dlynch7/MIDI2CV/README.md

# MIDI2CV
Convert MIDI messages to control voltage signals for use with a modular synthesizer

---

Jump to [Arduino Program](#arduino-program) if you want to see the current Arduino program. Otherwise, read on!

## Contents
- [Motivation](#motivation)
- [Plan](#plan)
- [Details](#details)
	- [Digital-to-Analog Converter Options](#digital-to-analog-converter-options)
		- [Filtered PWM](#filtered-pwm)
			- [1-pole LPF math](#1-pole-lpf-math)
			- [1-pole LPF for Pitch CV](#1-pole-lpf-for-pitch-cv)
			- [Sallen-Key Filter](#sallen-key-filter)
			- [2-pole Sallen-Key LPF for Pitch CV](#2-pole-sallen-key-lpf-for-pitch-cv)
		- [Dedicated DAC](#dedicated-dac)
- [Arduino Program](#arduino-program)
- [Further Plans](#further-plans)

---

## Motivation

Today, most music keyboards and synthesizers use [MIDI](https://www.midi.org/) (Musical Instrument Digital Interface), a digital communication protocol almost universally accepted in the electronic music industry. However, before MIDI's emergence in the 1980s, analog synthesizers often used _control voltage_ (CV) signals for control (surprisingly!) and communication.

I recently started building a modular synthesizer, using the [Music From Outer Space](http://musicfromouterspace.com/index.php?MAINTAB=SYNTHDIY&VPW=1910&VPH=844) (MFOS) series of modules as a starting point, and I wanted to play it with my keyboards and the DAW (digital audio workstation) on my computer.

With a device to convert MIDI messages to CV signals, I could play my modular synth using any MIDI-capable keyboard or my computer. While using a keyboard to play the modular synth makes improvising and jamming easier and more fun, I'm especially excited about the possibility of writing music on my computer and playing it back on the modular synth, because this will greatly expand my toolset for writing and recording music.

## Plan

This project is essentially a specialized digital-to-analog converter (DAC). While there are already many options for MIDI-to-CV conversion, I wanted to make my own converter.

In retrospect, this was a great decision
* I learned a lot more about MIDI and about the CV method it replaced.
* I gained an appreciation for the level of complexity required to generate some very common synth sounds (like [this one](https://youtu.be/SwYN7mTi6HM)!). I also _really_ gained an appreciation for the complexity required for polyphony in synthesizers!
* Designing and building this converter gave me an opportunity to apply what I'd learned in my coursework and improve my troubleshooting skills.

While there are [some](http://musicfromouterspace.com/index.php?MAINTAB=SYNTHDIY&VPW=1910&VPH=844) MIDI-to-CV converters out there that do the job without resorting to a microcontroller, I wanted to go the microcontroller route, for a few reasons:
* it's easier to reprogram a _&mu;_C than it is to rebuild a circuit
* more documentation available
* more room for error/experimentation
* I already had an Arduino Uno on hand

Given the last bullet point above, my converter could be represented like this:

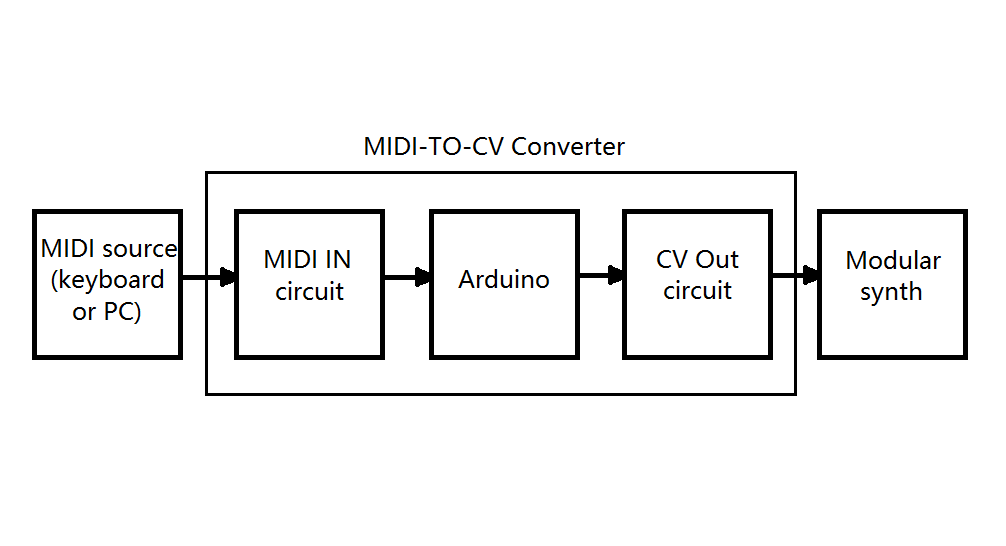
[picture p1: images/blockdiagram.png]
Block Diagram


-------

## Details

Sort of. Rather than try to explain the MIDI communication protocal myself, here are some other websites and people who've done a great job explaining it:

* This [Instructable](http://www.instructables.com/id/What-is-MIDI/) gives a comprehensive and comprehensible overview of MIDI. The author also wrote an [Instructable](http://www.instructables.com/id/Send-and-Receive-MIDI-with-Arduino/) about using an Arduino to send and receive MIDI messages; this particular Instructable was an invaluable resource throughout my project.
* This [blog post](http://www.notesandvolts.com/2015/02/midi-and-arduino-build-midi-input.html) also gives a clear description of the MIDI input circuit.
* Here is a [library](https://github.com/FortySevenEffects/arduino_midi_library) of code for Arduino to interface with MIDI. This is what I used to interface with my MIDI keyboard.

The schematic below shows the three circuits required by MIDI. Since my project only has a MIDI input, I only used the topmost circuit.

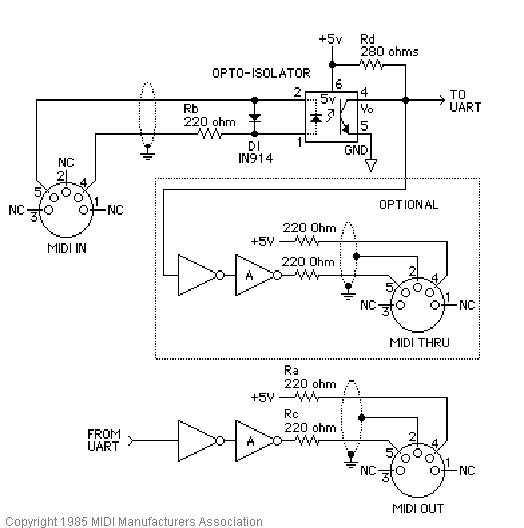
[picture p2: images/midicircuit.gif]
MIDI circuit


**Note:** MIDI transmits at a baud rate of 31250. The Arduino IDE doesn't support this baud rate, so if you want to print data for debugging purposes, you'll have to use an additional program to view serial data. I use [PuTTY](http://www.chiark.greenend.org.uk/~sgtatham/putty/download.html). Just follow [this tutorial](http://acidotunismo.com/en/2013/10/arduino-uno-midi-in-debugging-with-putty-windows/).

Briefly, MIDI uses bytes to convey a wide array of musical information, such as
* **note On/Off** (are you pressing a key?)
* **pitch** (what key are you pressing?)
* **velocity** (how hard are you pressing the key?)
* **pitchbend** (most MIDI keyboards have a control wheel for bending a note up or down)
* **modulation** (most MIDI keyboards also have a modulation wheel that can be assigned to modulate another parameter, such as vibrato, filter cutoff frequency, etc.)
* **sustain** (are you pressing down on a sustain pedal, like on a piano?)

There are many, many more MIDI messages available, but these are some of the most common and are also the ones I use most often when playing.

CV conveys the same information as MIDI but does it differently, using both analog and logic-level signals.
* MIDI **note on/off** messages map to logic-level **GATE** and **TRIGGER** CV signals.
* Pretty much every other MIDI message maps to an analog CV signal
    * pitch
    * velocity
    * modulation
The beauty of CV is that these analog CV signals are interchangeable. This flexibility opens more possibilities for sound design. Here are just a few examples:
* velocity CV -> filter cutoff frequency (sound brightens with harder keypresses)
* pitch CV -> oscillator mix (use pitch to blend between two different waveforms)
* modulation -> low frequency oscillator (LFO) amplitude (LFOs are another signal generator that will also output CV signals and can modulate more aspects of your sound)

### Digital-to-Analog Converter Options

I considered two methods for converting the Arduino's digital output to analog CV signals, and I actually wound up using both methods.

1. Dedicated DAC chip
2. Pulse Width Modulation (PWM) + Low-Pass Filter (LPF).

Before this project, I never used a dedicated DAC, and because I initially felt hesitant about that method, I decided to see if I could do all my digital-to-analog conversion using filtered PWM.

#### Filtered PWM

The Arduino's [analogWrite()](https://www.arduino.cc/en/Reference/AnalogWrite) function uses PWM to approximate a voltage between 0V and 5V. While some devices (LEDs, DC motors) can be controlled directly by PWM, the synthesizer is not one of those devices (unless you want to generate some interesting 'talking-robot' sounds). For PWM to interface nicely with my modular, it had to be low-pass filtered to 'smooth out' the signal. The simplest LPF is a resistor-capacitor (RC) circuit, as shown below, so I started there, with the expectation that a more sophisticated filter might be necessary.

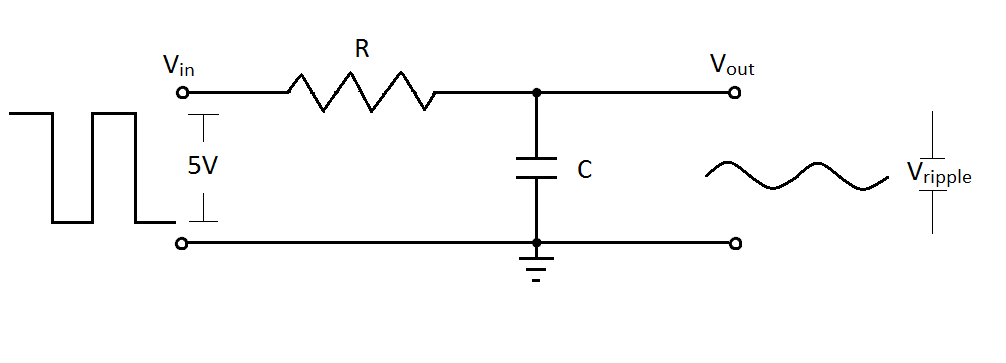
[picture p3: images/lpf_1pole_circuit.png]
RC circuit


A buffer is necessary to prevent whatever is connected to the filter's output from loading down the filter. This can be done with a voltage-follower, shown below with the original RC circuit.

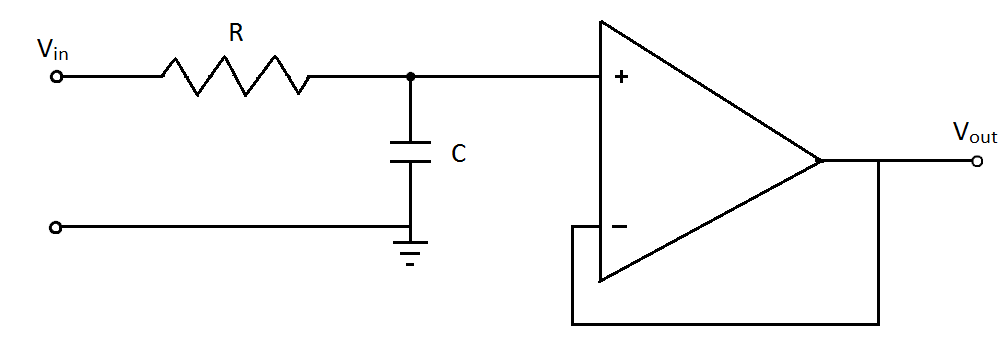
[picture p4: images/lpf_1pole_buffer.png]
Buffered RC circuit


Note: I might use "bandwidth frequency" and "cutoff frequency" interchangeably, because for low-pass filters, they mean the same thing.

An RC circuit is a 1-pole filter, which means that above its cutoff frequency, the filter has a slope of -20 dB per decade (i.e. if the filter attenuates a 100 Hz input signal by 20 dB, it will attenuate a 1000 Hz input signal by 40 dB). The Bode plot below illustrates the frequency response of this circuit.

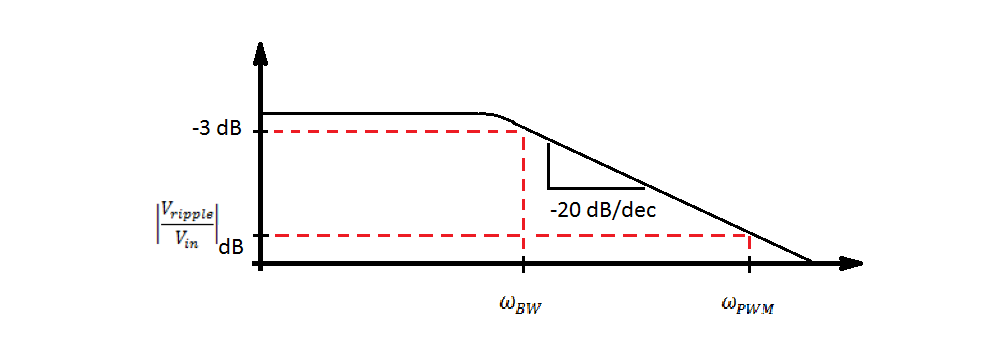
[picture p5: images/lpf_1pole.png]
RC bode


This Bode plot is also quite helpful for understanding my design process; the process applies for higher-order filters, too, and the only difference is that the Bode plot would look different (it would have a steeper slope).

For clarity, I want to list the parameters relevant to using an RC circuit to filter a PWM signal from the Arduino.
* Arduino PWM frequency
* LPF cutoff frequency
* PWM amplitude
* Ripple amplitude (amplitude of filtered PWM signal)

For the RC circuit described above, the cutoff frequency is a function of the resistor and capacitor values, R and C. Also, the frequency and amplitude of the Arduino's PWM signal are fixed: 490 Hz (980 Hz on pins 5 and 6) and 5V, respectively.

The design procedure then is this:
```
1. Determine a desirable ripple magnitude.
2. Given the filter's -20 dB/dec slope, calculate the cutoff frequency required to achieve the ripple amplitude.
```

##### 1-pole LPF math
  The transfer function for an RC LPF is

  lpf_1pole_TF		[1]

  The bandwidth frequency or cutoff frequency of a filter is the frequency at which the filter's output is 3 dB less than its DC level. For an RC LPF, this is simply -3 dB.

  lpf_1pole_BW_TF		[2]

  Solving for &omega; gives the cutoff frequency as a function of R and C:

  lpf_1pole_BW_freq		[3]

  Define RC as a time constant _&tau;_, and the equation above can be rewritten as

  lpf_1pole_BW_tau		[4]

Below, I'll describe how I followed this procedure to design a filter to smooth out a CV signal which could be used for pitch control:

##### 1-pole LPF for Pitch CV
  **Spoiler Alert!** This design doesn't work (as I'll explain below). That's why there are two section below labeled [Sallen-Key Filter](#sallen-key-filter) and [2-pole Sallen-Key LPF for Pitch CV](#2-pole-sallen-key-lpf-for-pitch-cv). Nevertheless, it's important to understand why this filter didn't work and why a more sophisticated filter was required.

  Recall that step 1 of the design procedure required me to determine a desirable ripple amplitude. Since I was designing a filter to generate a pitch CV signal, this ripple amplitude corresponded to a variability in pitch, kind of like a vibrato, so I had to decide how much vibrato I was willing to tolerate (not much).

  * I measured pitch variation in _cents_. A cent is 1/100th of a semitone (the difference in pitch between two adjacent keys on a piano, like C and C#).
  * I decided to tolerate +/- 5 cents variation in pitch, or a magnitude of 10 cents.
  * The voltage-controlled oscillator (VCO) of my synth is calibrated to 1V/octave, so two pitch CV signals 1V apart will make the VCO generate sounds 1 octave apart.
  * There are 12 semitones in an octave, so 1V/octave is equivalent to 1/12V per semitone.
  * Thus, 1 cent equals 0.8333 mV, and 10 cents equals 8.333 mV.
  * pitch_var_magnitude
  * Recall that for most pins on the Arduino, the PWM frequency is 490 Hz or 3079 rad/s, and the PWM signal switches between 0V and 5V.
  * Solving the equation above for time constant &tau; gives &tau; = 0.196 s.
  * Plugging this _&tau;_ into equation 3 above gives a cutoff frequency of 5.11 rad/s or 0.813 Hz. That's pretty low!
  * Using the MATLAB script [lpf1p.m](/matlab/lpf1p.m), I examined the frequency response and 0-5V step response of this filter, for a PWM frequency of 490 Hz, both of which are plotted below. Using the MATLAB function [stepinfo()](https://www.mathworks.com/help/control/ref/stepinfo.html), I found the settling time of this filter to be about 0.76 seconds. Considering the input PWM frequency is 490 Hz, that's an unacceptably slow settling time. Even if I used pins 5 or 6 (980 Hz PWM instead of 490 Hz), the settling time would have been around 0.38 s, still way too slow.

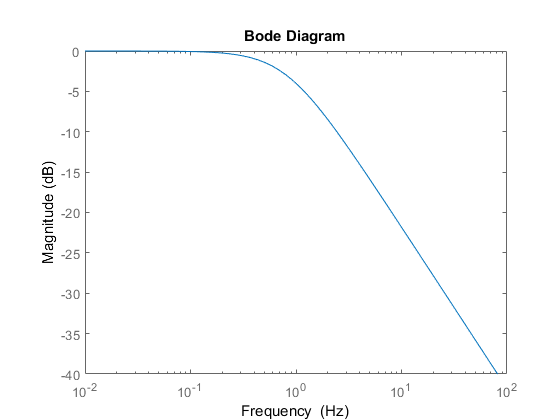
[picture p6: images/matlab_plots/lpf_1pole_bode.png]
1-Pole LPF Bode
  
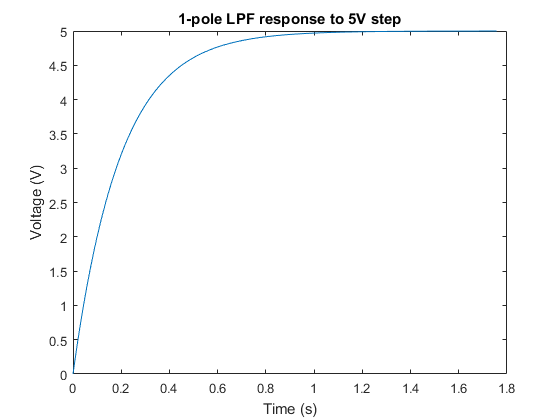
[picture p7: images/matlab_plots/lpf_1pole_5V_step_response.png]
1-Pole LPF 0-5V Step
  

  If I was determined to use a 1-pole RC LPF, I would have to tolerate more pitch variability. Instead, I decided to try a 2-pole filter, which would have a -40 db/dec slope instead of the RC LPF's -20 db/dec slope.

##### Sallen-Key Filter
A [Sallen-Key filter](https://en.wikipedia.org/wiki/Sallen%E2%80%93Key_topology) is an active 2-pole filter that can be designed to work as a cascade of two 1-pole RC filters.

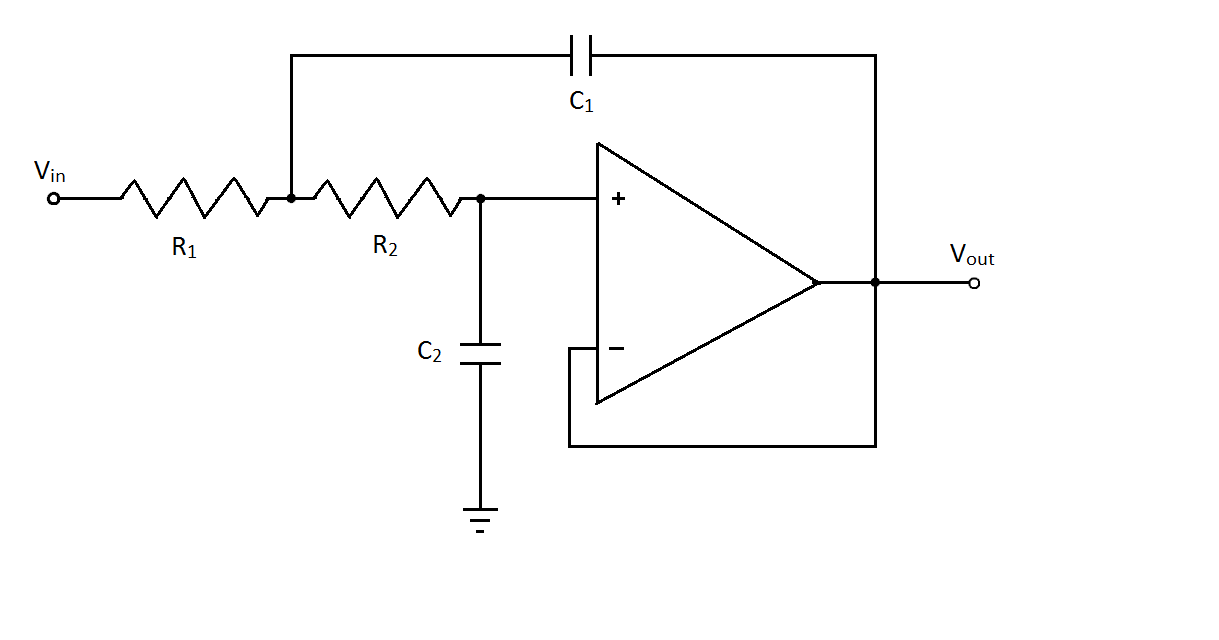
[picture p8: images/sallen-key_lpf.png]
Sallen-Key LPF


The generic transfer function for a Sallen-Key filter is

sallen-key_TF_generic		[5]

To make a Sallen-Key LPF,

sallen-key_LPF_Zs		[6]

The generic transfer function above becomes

sallen-key_LPF_TF		[7]

where

sallen-key_LPF_comp2canon		[8]

Here, _&omega;<sub>o</sub>_ is the natural frequency of the filter and _&zeta;_ is the damping coefficient of the filter.

For second-order systems, such as this filter, there is a quality factor _Q_ defined as

quality_factor		[9]

For a maximally sharp corner, Q = 1/2. This makes the Sallen-Key LPF behave as two cascaded 1-pole LPFs.
To reduce the number of unknown variables, let _C<sub>1</sub>_ = _C<sub>2</sub>_ = _C_, _R<sub>1</sub>_ = _R_, and _R<sub>2</sub>_ = _m*R_. Then, equation 9 becomes

quality_factor_compvals		[10]

Solving for _m_ gives _m_ = 1, which means _R<sub>1</sub>_ = _R<sub>2</sub>_. With _C<sub>1</sub>_ = _C<sub>2</sub>_ = _C_ and _R<sub>1</sub>_ = _R<sub>2</sub>_ = _R_, the filter's natural frequency becomes

SK_natF_compvals		[11]

and the damping coefficient _&zeta;_ becomes 1 (i.e. the filter is critically damped). Above the natural frequency, the filter has a slope of -40 dB/dec (twice as steep as a 1-pole LPF).

##### 2-pole Sallen-Key LPF for Pitch CV

Designing a Sallen-Key LPF to smooth PWM requires finding a natural frequency _&omega;<sub>o</sub>_ that yields the desired ripple amplitude. Starting with the canonical form of the filter transfer function,

SK_TF_canonical		[12]

and evaluating the transfer function along the imaginary axis _s_ = _j%omega;_, the transfer function becomes

SK_TF_canonical_jw		[13]

Recall that this filter is critically damped (_&zeta;_ = 1), so the equation above simplifies to

SK_TF_canonical_jw_simp		[14]

The magnitude of the filter is

SK_TF_mag		[15]

and the magnitude of the filtered PWM signal, normalized by the 5V PWM amplitude, is

SK_TF_ripplemag		[16]

Solving the equation above for _&omega;<sub>o</sub>_ gives the filter's natural frequency as a function of the PWM frequency _&omega;<sub>PWM</sub>_ and desired ripple amplitude |G<sub>ripple</sub>|:

SK_natF_from_PWM		[17]

Recall from the design procedure for the 1-pole LPF that the desired normalized ripple magnitude is 0.001666. I decided to use the faster PWM available from pins 5 and 6 on the Arduino, so _&omega;<sub>PWM</sub>_ = 6158 rad/s. Plugging these values into the equation above gives

SK_natF_solved

The last step of the design procedure is to choose values of _R_ and _C_ to achieve this natural frequency. With the components I had readily available, I chose _R_ = 39 k&Omega; and _C_ = 0.1 &mu;F, resulting in a natural frequency of 256 rad/s or 40.8 Hz.

How well does this filter perform? I wrote a short MATLAB script ([lpf2p_calc.m](/matlab/lpf2p_calc.m)) to generate a Bode plot and a 0-5V step response as well as some characteristics of the step response. Both plots are below. The normalized magnitude of the filtered PWM signal is 0.0017 and the step response settling time is roughly 0.02 seconds.

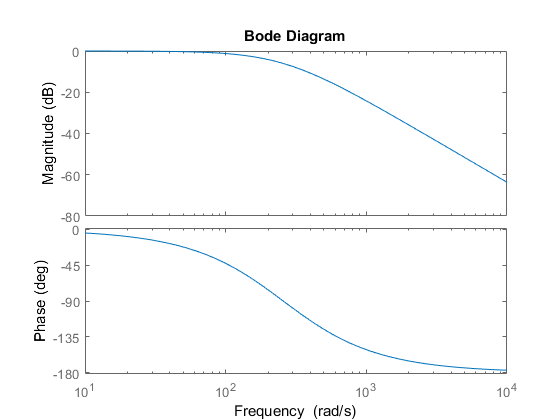
[picture p9: images/matlab_plots/lpf_2pole_bode_actual.png]
lpf_2pole_bode_actual


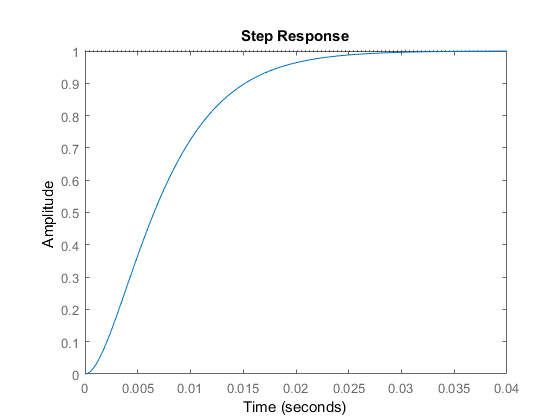
[picture p10: images/matlab_plots/lpf_2pole_5V_step_response_actual.png]
lpf_2pole_5V_step_response_actual


#### Dedicated DAC
Although the Sallen-Key LPF did its job well, the whole filtered PWM solution still didn't work for generating _pitch CV_ (it works fine for velocity modulation CVs), because of limited PWM resolution: the Arduino function [analogWrite()](https://www.arduino.cc/en/Reference/AnalogWrite) only has 8-bit resolution. This means the Arduino can use PWM to approximate 256 different values between 0V and 5V.

MIDI notes span 10+ octaves, or 128 notes, so you'd think 256 different PWM duty cycles would be enough to generate pitch CV, but you'd be wrong! Look at this table to see why:

| DAC Resolution | Number of Steps | Steps/semitone  | Acceptable? |
| --- |:---:| ---:| ---:|
| 8-bit | 256 | 2.1333 | No! |
| 12-bit | 4096 | 34.1333 | Yes. |
| 16-bit | 65536 | 546.1333 | Yes! |

With a non-integer number of steps per semitone, it's hard to get an in-tune pitch out of the synthesizer. Ascending up the keyboard from C0, the lowest MIDI note, an 8-bit DAC (comparable to analogWrite() on the Arduino) will get out of tune much sooner than a 12-bit or 16-bit DAC.

I anticipated having to manually tune my DAC values, so I opted for a 12-bit DAC, the [MCP4725](https://www.sparkfun.com/products/12918) (as opposed to a 16-bit DAC; manually tuning DAC values for that would be a nightmare!). This DAC comes on a breakout board and there's an [Arduino library](https://github.com/adafruit/Adafruit_MCP4725) for it, so using it in my project was pretty straightforward. [This tutorial](https://learn.sparkfun.com/tutorials/mcp4725-digital-to-analog-converter-hookup-guide) is also pretty helpful for getting started.

The tutorial comes with a simple sine wave generator. I uploaded that code to the Arduino and made a quick (and very shaky) video of the results. **Keep the volume low!**

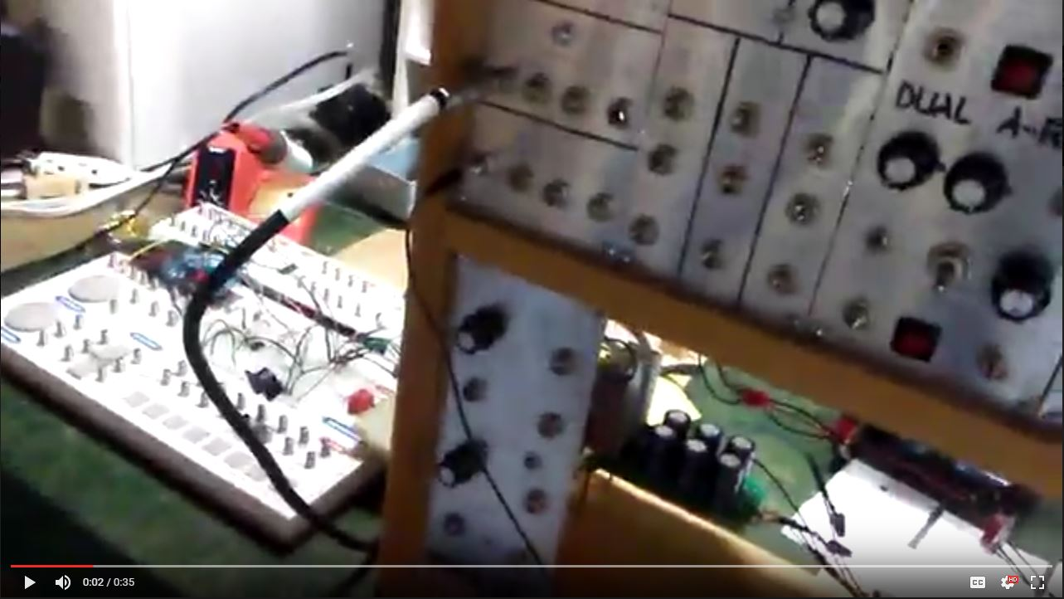
[picture p11: images/video_links/sine_wave.JPG]
sine_wave (https://drive.google.com/file/d/0B5OA5X2encENVUV6MTRTQzJISjA/view?usp=sharing)


and here's a second one:

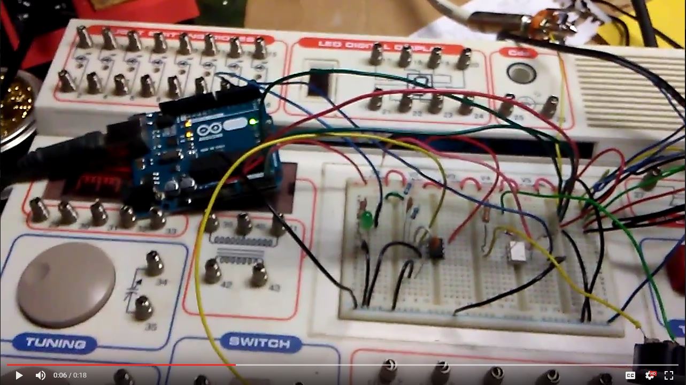
[picture p12: images/video_links/sine_wave2.JPG]
sine_wave2 (https://drive.google.com/file/d/0B5OA5X2encENRVZDSG9PbEpKSXM/view?usp=sharing)


Although I initially planned to design my MIDI-to-CV converter to generate pitch CV signals over a 10-octave range, at this point I decided to switch to a 5-octave range for 2 reasons:

1. My synth's VCO has a pretty good operational range, more than 8 octaves, but my MIDI keyboards only have 3-, 4-, and 5-octave ranges. I can expand that range by using the Coarse and Fine tuning knobs on the VCO.
2. Since the Arduino's PWM has a range of 5V, generating CV signals of >5V requires amplification and connection to my synth's power supply (a +/- 12 V bipolar power supply) Although I wound up amplifying the PWM signal for velocity CV, I didn't want to connect too many things to the synth's power supply because I want to be able to power more modules in the future (more VCOs, more envelope generators, etc).

With a 5-octave (5V) range in mind, I could calculate the values I'd need to write to the DAC:

1. Since the DAC has 12-bit resolution, it can output 4096 different voltages between 0V and V<sub>cc</sub> (5V). So, one volt corresponds to 4096/5 = 819.2.
2. An octave comprises 12 semitones, and with my 1V/octave VCO, a semitone corresponds to 1/12 V. So, one semitone corresponds to (4096/5)/12 = 68.2666. This means that to get C0 from the VCO, I'd write 0 to the DAC; to get C#0, I'd write 68; to get D0, I'd write 136, etc.

I used [this Excel spreadsheet](/math/MIDI_note_number_to_DAC_input.xlsx) to find the values I'd need to write to the DAC, assuming ideal conditions (Vcc = 5.00000V, perfectly in-tune VCO, etc).

Because tuning my VCO wasn't going well, I decided to adjust the numbers generated from the Excel spreadsheet so I'd have an in-tune playable synth. Later, I plan to properly tune the VCO and revert to the predicted DAC values generated by the Excel spreadsheet.

Once I adjusted the numbers I was writing to the DAC, I made another video:

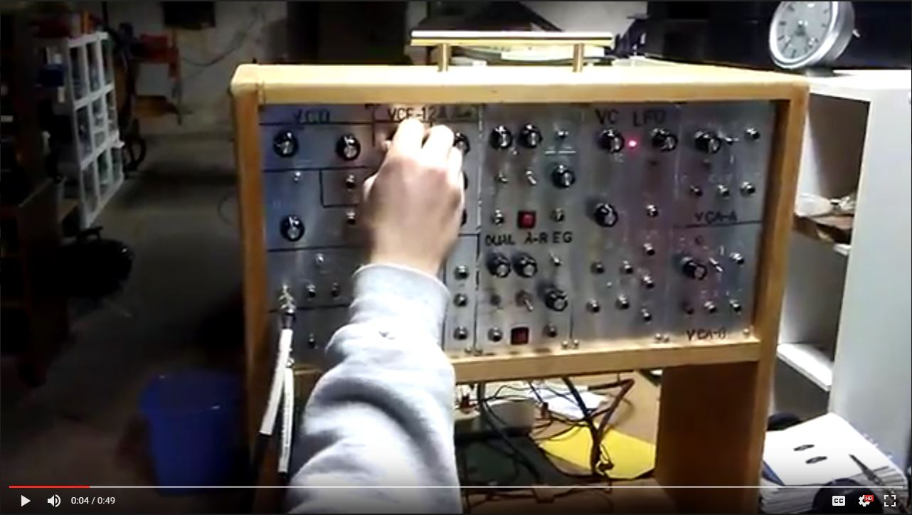
[picture p13: images/video_links/pitch_cv_only.JPG]
pitch_cv_only (https://drive.google.com/file/d/0B5OA5X2encENdHJBQ3NPME1DWUE/view?usp=sharing)


In that video, I'm manually adjusting the cutoff frequency of my synth's voltage-controlled filter (VCF) and playing my keyboard with my left hand (out of frame, sorry). Here's another video:

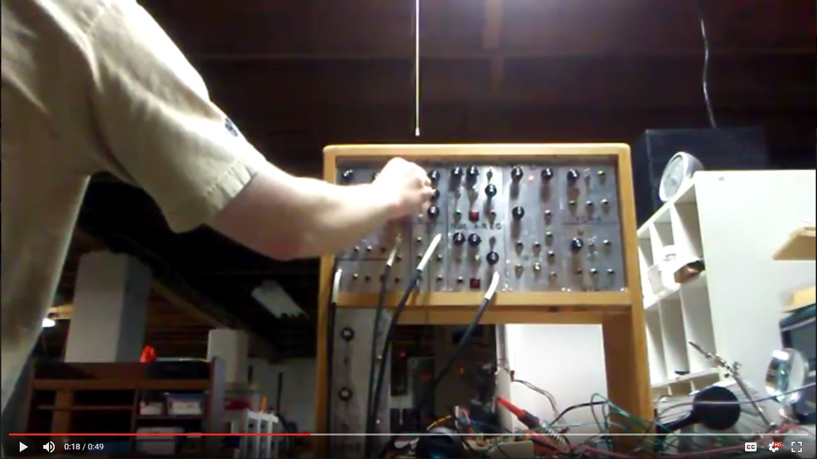
[picture p14: images/video_links/pitch_cv_w_EG.JPG]
pitch_cv_w_EG (https://drive.google.com/file/d/0B5OA5X2encENVm5hWGRBNEFaVHc/view?usp=sharing)


In that video, I rigged up a simple patch on the synth: I connected the output of my envelope generator (EG) to the cutoff CV input on the VCF. I used a similar method in the next 2 videos, when I began developing the velocity CV

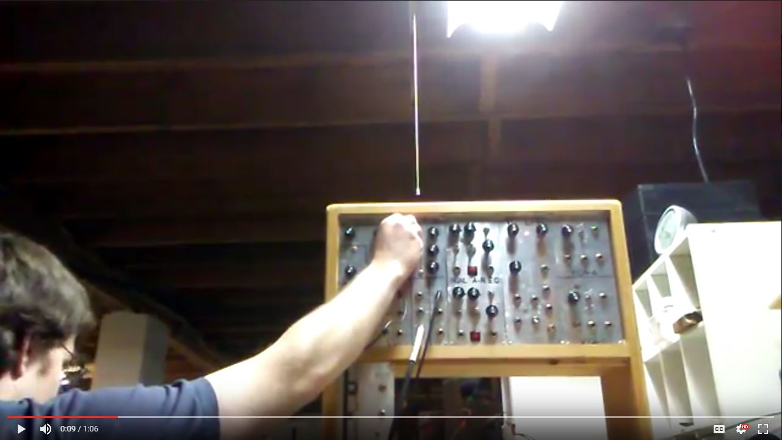
[picture p15: images/video_links/pitch_and_vel_cv.JPG]
pitch_and_vel_cv (https://drive.google.com/file/d/0B5OA5X2encENYnlNdWZTQ3JnVFU/view?usp=sharing)


In that video, the Arduino is just generating logic-level velocity CV signals, so I'm manually adjusting the VCF's cutoff frequency to add some more musicallity. In the next video, I got the velocity CV fully working so I wouldn't have to tweak any knobs while playing.

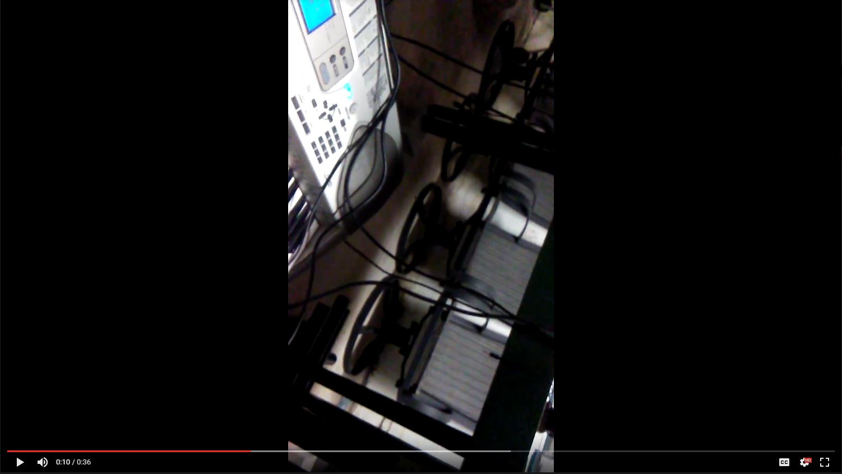
[picture p16: images/video_links/pitch_and_vel_cv2.JPG]
pitch_and_vel_cv2 (https://drive.google.com/file/d/0B5OA5X2encENS1duMlhIT1NpUWc/view?usp=sharing)


My apologies for the shakiness of the last video, and my apologies to Herbie Hancock for my rendition of "Chameleon"!

Here are some **important things** I learned while implementing velocity control:
* Although the Arduino can put out 0V, the TL-082 op-amp I used for my Sallen-Key LPF can't actually reach its rail voltages. As a result, when I connected the op-amp's V+ rail to the Arduino's 5V pin and the op-amp's V- rail to ground, the op-amp couldn't put out a signal as low as 0V!
* The solution to this problem is to connect the op-amp's V- to a negative voltage instead of ground. The only negative supply I had was -12V from the synth power supply. By using -12V and +12V instead of 0V and +5V, I could also amplify the velocity CV to cover a wider range! I'm still troubleshooting a non-inverting op-amp circuit I designed for this purpose, and I'll update this page once I get it working.

## Arduino Program
Here is my [Arduino program](/arduino/midi2pitchvelcv.ino), in its current state. I plan to update it according to my plans below:

## Further Plans
Above, I mentioned that I want to expand the range of my velocity CV and I have some troubleshooting to do on that front. I have some other features I want to implement:
* **Pitchbend:** implementing pitchbend should be straightforward.
  * I have to decide on a _pitchbend range_ (+/-2 semitones is common, although some cool sounds can be made with wider ranges like +/- 12 semitones). I would actually like to make that a parameter I could provide to the Arduino through some kind of interface, such as hex LEDs and either up/down buttons or a scrollwheel.
  * Once I have chosen a pitchbend range, I have to convert the MIDI pitchbend message to an increment/decrement and add that value to the value I'm writing to the DAC to generate the pitch CV. MIDI splits the pitchbend message into two parts, one for coarse resolution and one for fine resolution; I want to see how things sound if I just use coarse resolution before I attempt to use coarse + fine.
* **Modulation CV:** this is almost identical to velocity CV, so it should be easy to implement.
* **Gate and Trigger CV:** I have the Gate CV almost working, I just have to find what voltage the synth expects for a Gate HIGH condition and amplify the signal to reach that voltage. Getting the Trigger CV working will be a little trickier, because it's a momentary signal, but I suspect I can implement that entirely in the Arduino code, using a simple state machine.
* **Sustain CV:** I've found that I use the sustain pedal a lot when I play, so I'd really like to get this working. I have to understand how the MIDI sustain message works first. If it doesn't alter the MIDI Note On/Off message, I can combine the sustain and note on/off messages to generate the Gate CV.
* **PCB and Front Panel:** Since this whole project is for my modular synth, I'd like to build it as a module that I can add to the synth itself.

--------
