dlynch7/MIDI2CV/math/filter_derivations.docx

Low-pass filter as a rudimentary DAC

1- 1-pole LPF: RC circuit

Start with schematic including input and outputs (PWM and smoothed PWM). Also explain unity-gain buffer and include schematic of RC + buffer.

Transfer function:

(V_(out))/(V_(in))=1/(sRC+1)

Bandwidth:

-3 dB=1/(√2)=|(V_(out))/(V_(in))|=|1/(sRC+1)|=|1/(jω_(BW) RC+1)|=1/(√(1+(ω_(BW) RC)^2))

Solving for omega gives the bandwidth frequency as a function of R and C:

ω_(BW) =1/(RC) or f_(BW) =1/(2πRC)

Define

τ=RC

Equivalently,

τ=1/(ω_(BW))=1/(2πf_(BW))

For a given musical pitch, +/- 5 cents is an acceptable variation in pitch. The VCO is calibrated to 1V/octave or, equivalently, 1/12 V per semitone. A cent is 1/100th of a semitone, or 0.83333333 mV. A range of +/- 5 cents (10 cents) corresponds to 8.3333 mV

|(V_(out))/(V_(in))|_(ω_(PWM)) =(8.333 mV)/(5 V)=0.001666=1/(√(1+(ω_(PWM) τ)^2))

The Arduino Uno’s PWM-enabled pins output at 490 Hz or approximately 3079 rad/s, except pins 5 and 6, which output at 980 Hz or approximately 6158 rad/s. Taking ω_(PWM) =3079 (rad)/s , solve for τ :

τ=0.196 s

With a time constant τ = 0.196 s, the cutoff frequency of this filter is ω_(BW) =5.11 rad/s or f_(BW) =0.813 Hz .

2- 2-pole LPF: Sallen-Key filter

Sallen-Key TF:

(V_(out))/(V_(in))=(Z_3 Z_4)/(Z_1 Z_2 +Z_3 (Z_1 Z_2 )+Z_3 Z_4)

For an LPF,

Z_1 =R_1 , Z_2 =R_2 , Z_3 =1/(sC_1), and Z_4 =1/(sC_2)

The TF above becomes

(V_(out))/(V_(in))=1/(s^2 R_1 R_2 C_1 C_2 +sC_2 (R_1 +R_2 )+1)=(ω_o^2)/(s^2 +2αs+ω_o^2)

where

ω_o =1/(√(R_1 R_2 C_1 C_2)) , 2α=(R_1 +R_2)/(C_1 R_1 R_2)=2ζω_o , and ζ=((R_1 +R_2 )√(R_1 R_2 C_1 C_2))/(2C_1 R_1 R_2) .

Define a “quality factor” Q:

Q=(ω_o)/(2α)=(√(R_1 R_2 C_1 C_2))/(C_2 (R_1 +R_2 ))

For a maximally sharp corner, Q = ½.

To reduce the number of unknown from four ( R_1 , R_2 , C , and C_2 ) to three, let C_1 =C_2 =C , R_1 =R , and R_2 =mR . Then,

Q=1/2=(√(mR^2 C^2))/(RC(1+m))=(RC√m)/(RC(1+m))=(√m)/(1+m)

Solving for m gives m=1 , implying R_1 =R_2 . So, solving for m actually reduced the number of unknowns from four to two!

With C_1 =C_2 =C and R_1 =R_2 =R , the filter’s natural frequency becomes

ω_o =1/(RC)

and the damping coefficient ζ becomes 1 (i.e. critically damped). Above the natural frequency, the filter has a slope of -40 dB/dec (compared to the -20 dB/dec of a 1-pole LPF). Note that setting Q equal to ½ makes the Sallen-Key LPF behave like two cascaded 1-pole RC LPFs.

Designing a Sallen-Key LPF to smooth PWM requires finding a natural frequency that yields the desired ripple amplitude. Starting with the canonical form of the filter transfer function

|(V_(out) (s))/(V_(in) (s))|=G(s)=(ω_o^2)/(s^2 +2ζω_o s+ω_o^2)=1/((s/(ω_o))^2 +(2ζ)/(ω_o)s+1)

Evaluating the transfer function along the imaginary axis s=jω ,

G(jω)=1/(1-(ω/(ω_o))^2 +j(2ζω)/(ω_o))=((1-(ω/(ω_o))^2 )+j((2ζω)/(ω_o)))/(1-2(ω/(ω_o))^2 +(ω/(ω_o))^4 +(4ζ^2 ω^2)/(ω_o^2))

Recall that this filter is critically damped ( ζ=1 ), so the equation above simplifies to

G(jω)=((1-(ω/(ω_o))^2 )+j((2ω)/(ω_o)))/(1+2(ω/(ω_o))^2 +(ω/(ω_o))^4)=((1-(ω/(ω_o))^2 )+j((2ω)/(ω_o)))/((1+(ω/(ω_o))^2 )^2)

The magnitude of G is

|G(jω|=√(Re(G)^2 +Im(G)^2)=√((ω_o^4)/((ω^2 +ω_o^2 )^2))

The magnitude of the filtered PWM is

|G_(ripple) |=|G(jω_(PWM) |=√((ω_o^4)/((ω_(PWM)^2 +ω_o^2 )^2))

Solving for ω_o (I used Mathematica):

ω_o =(ω_(PWM) √(|G_(ripple) |))/(√(1-|G_(ripple) |))

Recall from the design procedure for the 1-pole LPF that the desired ripple magnitude is |G_(ripple) |=0.001666 . I decided to use the faster PWM available from pins 5 and 6 on the Arduino, so ω_(PWM) =6158(rad)/s . Plugging these values into the equation above gives

ω_o =(6158√0.001666)/(√(1-0.001666))=251 rad/s=40 Hz

The last step of the design procedure is to choose values of R and C such that ω_o =1/(RC) (or as close as possible using commonly-available component values). With the components I had readily available, I chose R = 39 kΩ and C = 0.1 µF, resulting in a natural frequency of 256 rad/s or 40.8 Hz.
