dlynch7/MIDI2CV/(commit log)

2016-12-28 images for 1-pole low-pass filter
2016-12-28 magnitude of filtered PWM ripple
2016-12-28 sallen-key LPF schematic
2016-12-31 Excel sheet to find DAC vals for pitch CV
    [MIDI_note_number_to_DAC_input.xlsx]
2016-12-31 vid thumbnail: DAC sine wave pitch CV
2016-12-31 pitch and velocity CV working
